Sxyther/HG_Badge_v1-0/BoM.xlsx

Part | Value | Device | Package | Description
C1 | 0.1uF | Capacitor | 0603-CAP | Capacitor | Any 0603 capacitor
C2 | 0.1uF | Capacitor | 0603-CAP | Capacitor | Any 0603 capacitor
C3 | 0.1uF | Capacitor | 0603-CAP | Capacitor | Any 0603 capacitor
C4 | 10uF | Capacitor | 1206-CAP | Capacitor Polarized | Any 1206 capacitor
C5 | 0.01uF | Capacitor | 0603-CAP | Capacitor | Any 1206 capacitor
C6 | 0.1uF | Capacitor | 0603-CAP | Capacitor | Any 0603 capacitor
C7 | 10uF | Capacitor | 0603-CAP | Capacitor | Any 0603 capacitor
C8 | 100pF | Capacitor | 0603-CAP | Capacitor | Any 0603 capacitor
FB1 | 300 ohm | FERRITE0805 | 0805-Ferrite | Ferrite Bead | https://www.digikey.com/product-detail/en/bourns-inc/MU2029-301Y/MU2029-301YTR-ND/1970484
FB2 | 300 ohm | FERRITE0805 | 0805-Ferrite | Ferrite Bead | https://www.digikey.com/product-detail/en/bourns-inc/MU2029-301Y/MU2029-301YTR-ND/1970484
LED1 | White | LED | 0603-LED | LEDs | https://www.digikey.com/product-detail/en/osram-opto-semiconductors-inc/LS-Q976-NR-1/475-2512-1-ND/1802639
LED2 | White | LED | 0603-LED | LEDs | https://www.digikey.com/product-detail/en/osram-opto-semiconductors-inc/LS-Q976-NR-1/475-2512-1-ND/1802640
LED3 | White | LED | 0603-LED | LEDs | https://www.digikey.com/product-detail/en/osram-opto-semiconductors-inc/LS-Q976-NR-1/475-2512-1-ND/1802641
LED4 | White | LED | 0603-LED | LEDs | https://www.digikey.com/product-detail/en/osram-opto-semiconductors-inc/LS-Q976-NR-1/475-2512-1-ND/1802642
LED5 | White | LED | 0603-LED | LEDs | https://www.digikey.com/product-detail/en/osram-opto-semiconductors-inc/LS-Q976-NR-1/475-2512-1-ND/1802643
LED6 | White | LED | 0603-LED | LEDs | https://www.digikey.com/product-detail/en/osram-opto-semiconductors-inc/LS-Q976-NR-1/475-2512-1-ND/1802644
LED7 | White | LED | 0603-LED | LEDs | https://www.digikey.com/product-detail/en/osram-opto-semiconductors-inc/LS-Q976-NR-1/475-2512-1-ND/1802645
Q1 | 8/16/20MHz | RESONATOR1:1 | RESONATOR-SMD-1:1 | Resonator | https://www.digikey.com/product-detail/en/murata-electronics-north-america/CSTCE16M0V53-R0/490-1198-1-ND/584635
R1 | 10K | RESISTOR0603-RES | 0603-RES | Resistor | Any 0603 resistor
R2 | 1K | RESISTOR0603-RES | 0603-RES | Resistor | Any 0603 resistor
R4 | 330 | RESISTOR0603-RES | 0603-RES | Resistor | Any 0603 resistor
R5 | 330 | RESISTOR0603-RES | 0603-RES | Resistor | Any 0603 resistor
R6 | 330 | RESISTOR0603-RES | 0603-RES | Resistor | Any 0603 resistor
R7 | 330 | RESISTOR0603-RES | 0603-RES | Resistor | Any 0603 resistor
R8 | 330 | RESISTOR0603-RES | 0603-RES | Resistor | Any 0603 resistor
R9 | 330 | RESISTOR0603-RES | 0603-RES | Resistor | Any 0603 resistor
R10 | 330 | RESISTOR0603-RES | 0603-RES | Resistor | Any 0603 resistor
R11 | 1K | RESISTOR0603-RES | 0603-RES | Resistor | Any 0603 resistor
R12 | 1K | RESISTOR0603-RES | 0603-RES | Resistor | Any 0603 resistor
R13 | 1M | RESISTOR0603-RES | 0603-RES | Resistor | Any 0603 resistor
R14 | 1M | RESISTOR0603-RES | 0603-RES | Resistor | Any 0603 resistor
R15 | 1k | RESISTOR0603-RES | 0603-RES | Resistor | Any 0603 resistor
R16 | 22k | RESISTOR0603-RES | 0603-RES | Resistor | Any 0603 resistor
U1 | ATMEGA328 | ATMEGA168 | TQFP32-08 |  | https://www.digikey.com/product-detail/en/microchip-technology/ATMEGA328-AUR/ATMEGA328-AURCT-ND/3440951
U2 | MAX4466EXK+T | MAX4466"" | SC70-5 | MAX4466 - Microphone Pre-Amp | https://www.digikey.com/product-detail/en/maxim-integrated/MAX4466EXK-T/MAX4466EXK-TR-ND/1781624
