Sxyther/HG_Badge_v1-0/HG_Badge_v1-0.pdf

# AGND 5 AREF 20

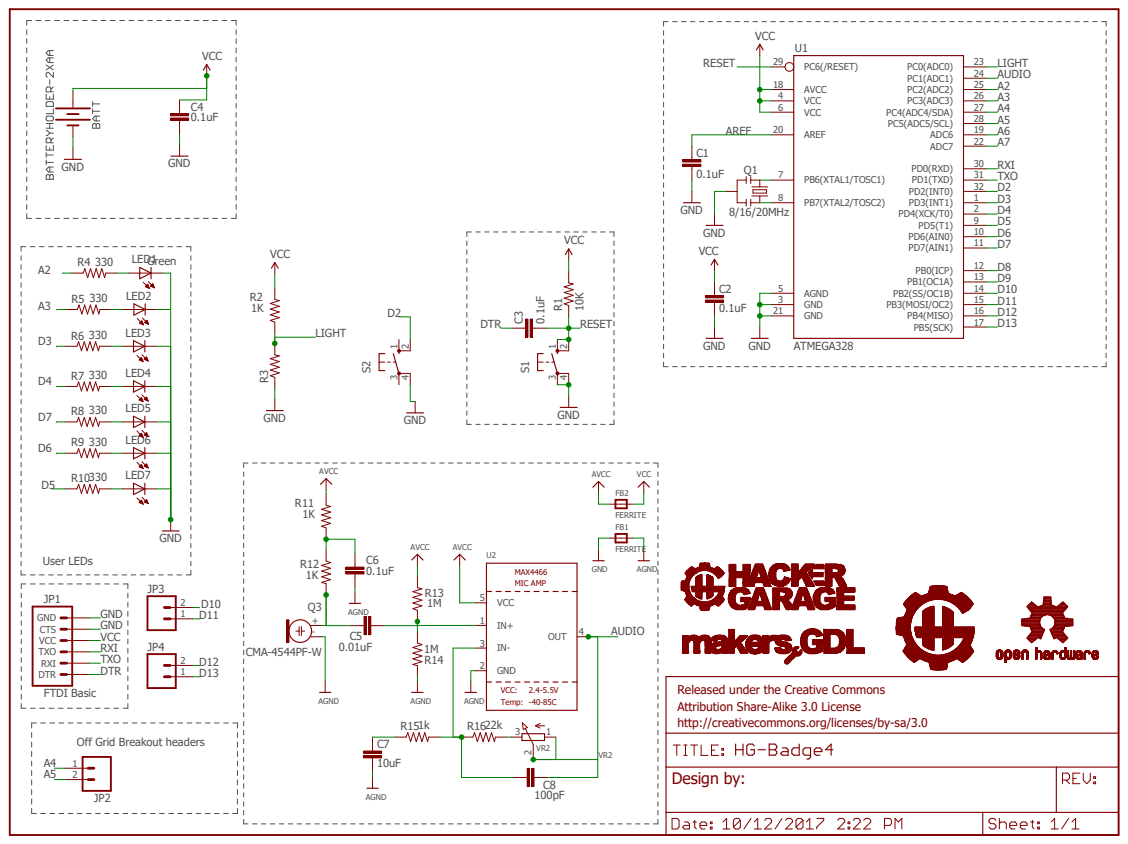
[picture p1: page 1]

Released under the Creative Commons
Attribution Share-Alike 3.0 License
http://creativecommons.org/licenses/by-sa/3.0
