Sxyther/HG_Badge_v1-0/HG-Badge6.brd

## EAGLE design HG-Badge6.brd (2018-12-18)

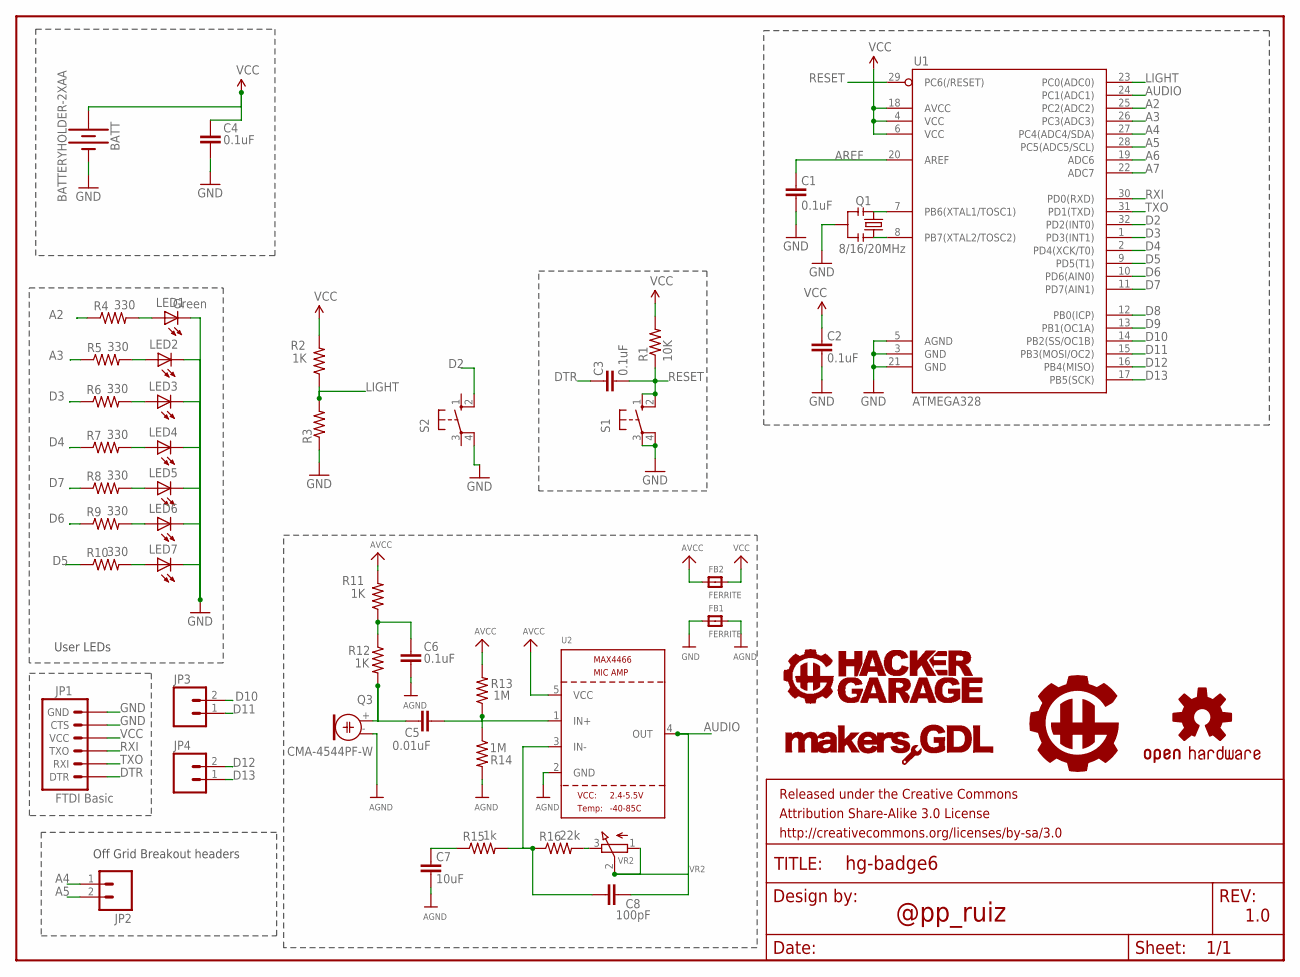
[picture p2: schematic HG-Badge6.sch]

Parts:
BATT: BATTERYHOLDER-2XAA; BATT-HOLDER-2XAAA
C1, C2, C3, C4, C6: 0.1uF; 0603-CAP
C5: 0.01uF; 0603-CAP
C7: 10uF; 0603-CAP
C8: 100pF; 0603-CAP
FB1, FB2: FERRITE; 0805
FRAME1: FRAME-LETTER; CREATIVE_COMMONS
JP1: FTDI Basic; 1X06
JP2, JP3, JP4: M02PTH; 1X02
LED1, LED2, LED3, LED4, LED5, LED6, LED7: Green; 0603-LED-ALT1
Q1: 8/16/20MHz; RESONATOR-SMD-1:1
Q3: CMA-4544PF-W; ELECTRET_9.7
R1: 10K; 0603-RES
R2, R11, R12: 1K; 0603-RES
R3: R-US_0204/2V; 0204V
R4, R5, R6, R7, R8, R9, R10: 330; 0603-RES
R13, R14: 1M; 0603-RES
R15: 1k; 0603-RES
R16: 22k; 0603-RES
S1, S2: 10-XX; B3F-10XX
U1: ATMEGA328; TQFP32-08
U2: MAX4466EXK+T; SC70-5
U$1: HG-BADGE-FULL; HG-BADGE
U$3: OSHW-LOGOS; OSHW-LOGO-S
U$4: MAKERSGDLLOGO-SMALL; MAKERSGGL-SMALL
U$5: HACKERGARAGEFULL; HACKERGARAGEFULL-SMALL
VR2: VR2; TRIMPOT_BOURNS_TC33X-2

Connections:
A2: R4.1, U1.25 (PC2(ADC2))
A3: R5.1, U1.26 (PC3(ADC3))
A4: JP2.1, U1.27 (PC4(ADC4/SDA))
A5: JP2.2, U1.28 (PC5(ADC5/SCL))
A6: U1.19 (ADC6)
A7: U1.22 (ADC7)
AGND: C6.1, C7.1, FB1.2, Q3.- (1), R14.2, U2.2 (GND)
AREF: C1.2, U1.20 (AREF)
AUDIO: C8.1, U1.24 (PC1(ADC1)), U2.4 (OUT), VR2.1 (A), VR2.2 (S)
AVCC: FB2.1, R11.2, R13.2, U2.5 (VCC)
D2: S2.2 (S1), U1.32 (PD2(INT0))
D3: R6.1, U1.1 (PD3(INT1))
D4: R7.1, U1.2 (PD4(XCK/T0))
D5: R10.1, U1.9 (PD5(T1))
D6: R9.1, U1.10 (PD6(AIN0))
D7: R8.1, U1.11 (PD7(AIN1))
D8: U1.12 (PB0(ICP))
D9: U1.13 (PB1(OC1A))
D10: JP3.2, U1.14 (PB2(SS/OC1B))
D11: JP3.1, U1.15 (PB3(MOSI/OC2))
D12: JP4.2, U1.16 (PB4(MISO))
D13: JP4.1, U1.17 (PB5(SCK))
DTR: C3.2, JP1.1 (DTR)
GND: BATT.P$1 (-), C1.1, C2.1, C4.1, FB1.1, JP1.5 (CTS), JP1.6 (GND), LED1.C, LED2.C, LED3.C, LED4.C, LED5.C, LED6.C, LED7.C, Q1.2, R3.1, S1.3, S1.4 (P1), S2.4 (P1), U1.3 (GND), U1.5 (AGND), U1.21 (GND)
LIGHT: R2.1, R3.2, U1.23 (PC0(ADC0))
unnamed: Q1.3, U1.8 (PB7(XTAL2/TOSC2))
unnamed: Q1.1, U1.7 (PB6(XTAL1/TOSC1))
unnamed: LED4.A, R7.2
unnamed: LED5.A, R8.2
unnamed: LED6.A, R9.2
unnamed: LED7.A, R10.2
unnamed: LED3.A, R6.2
unnamed: LED2.A, R5.2
unnamed: LED1.A, R4.2
unnamed: C8.2, R15.2, R16.1, U2.3 (IN-)
unnamed: C5.2, Q3.+ (2), R12.2
unnamed: C6.2, R11.1, R12.1
unnamed: C5.1, R13.1, R14.1, U2.1 (IN+)
unnamed: R16.2, VR2.3 (E)
unnamed: C7.2, R15.1
RESET: C3.1, R1.1, S1.1 (S), S1.2 (S1), U1.29 (PC6(/RESET))
RXI: JP1.3 (TXO), U1.30 (PD0(RXD))
TXO: JP1.2 (RXI), U1.31 (PD1(TXD))
VCC: BATT.P$2 (+), C2.2, C4.2, FB2.2, JP1.4 (VCC), R1.2, R2.2, U1.4 (VCC), U1.6 (VCC), U1.18 (AVCC)

Notes on the sheet:
Off Grid Breakout headers
User LEDs
1.0
@pp_ruiz

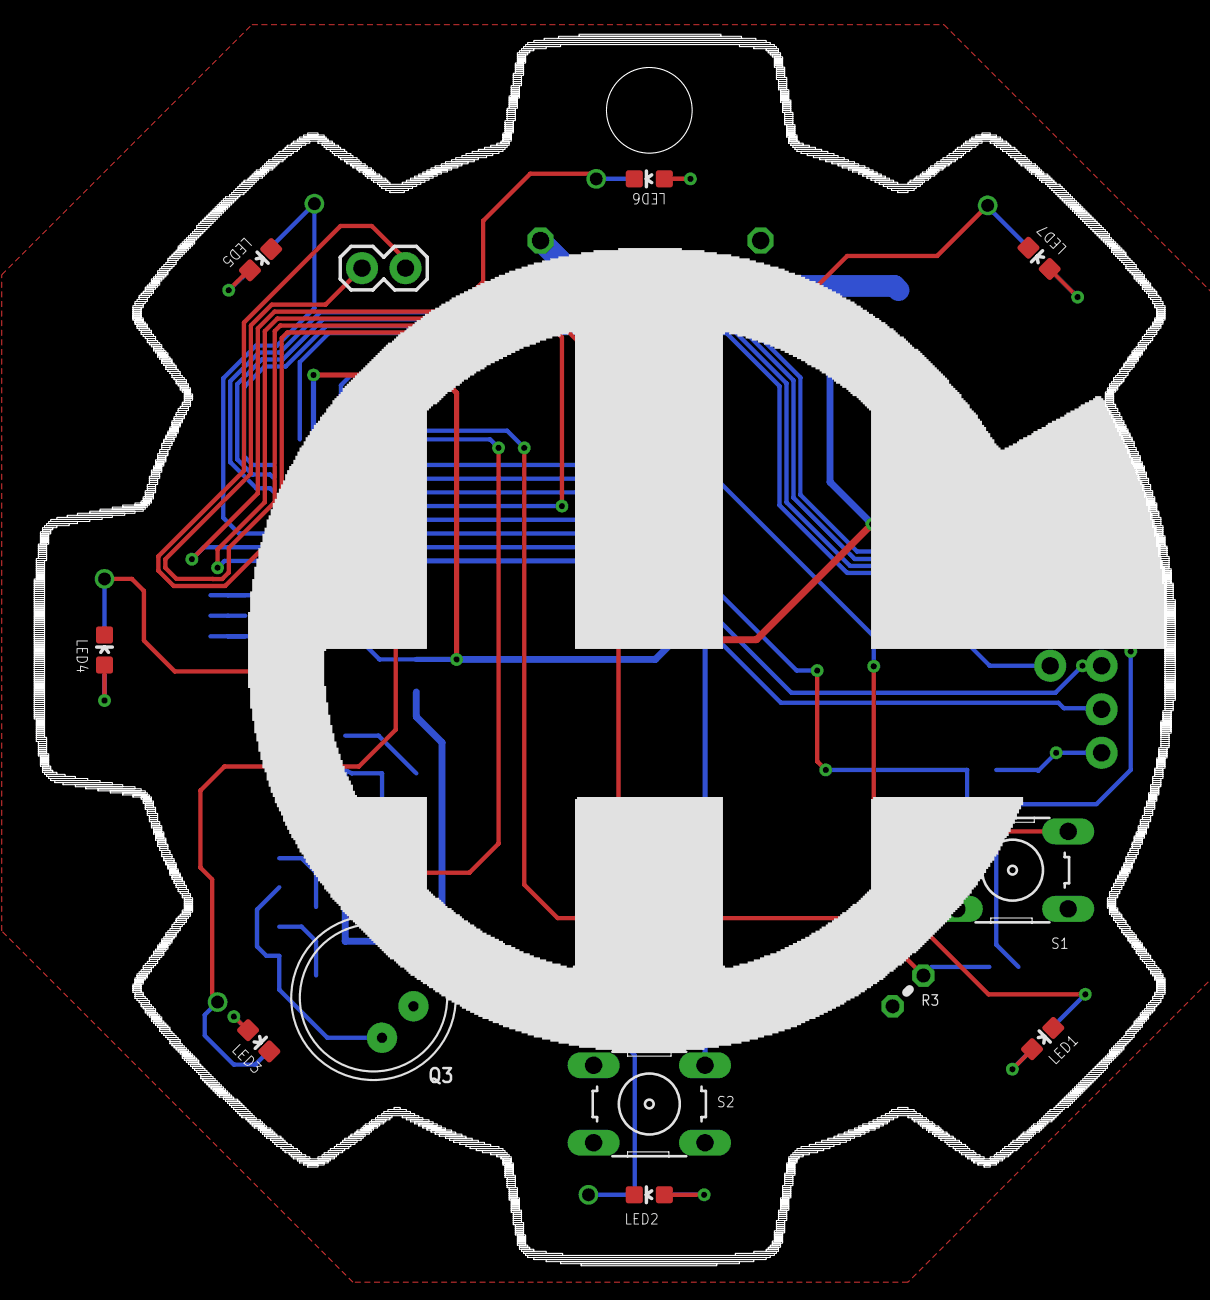
[picture p3: board HG-Badge6.brd from above]

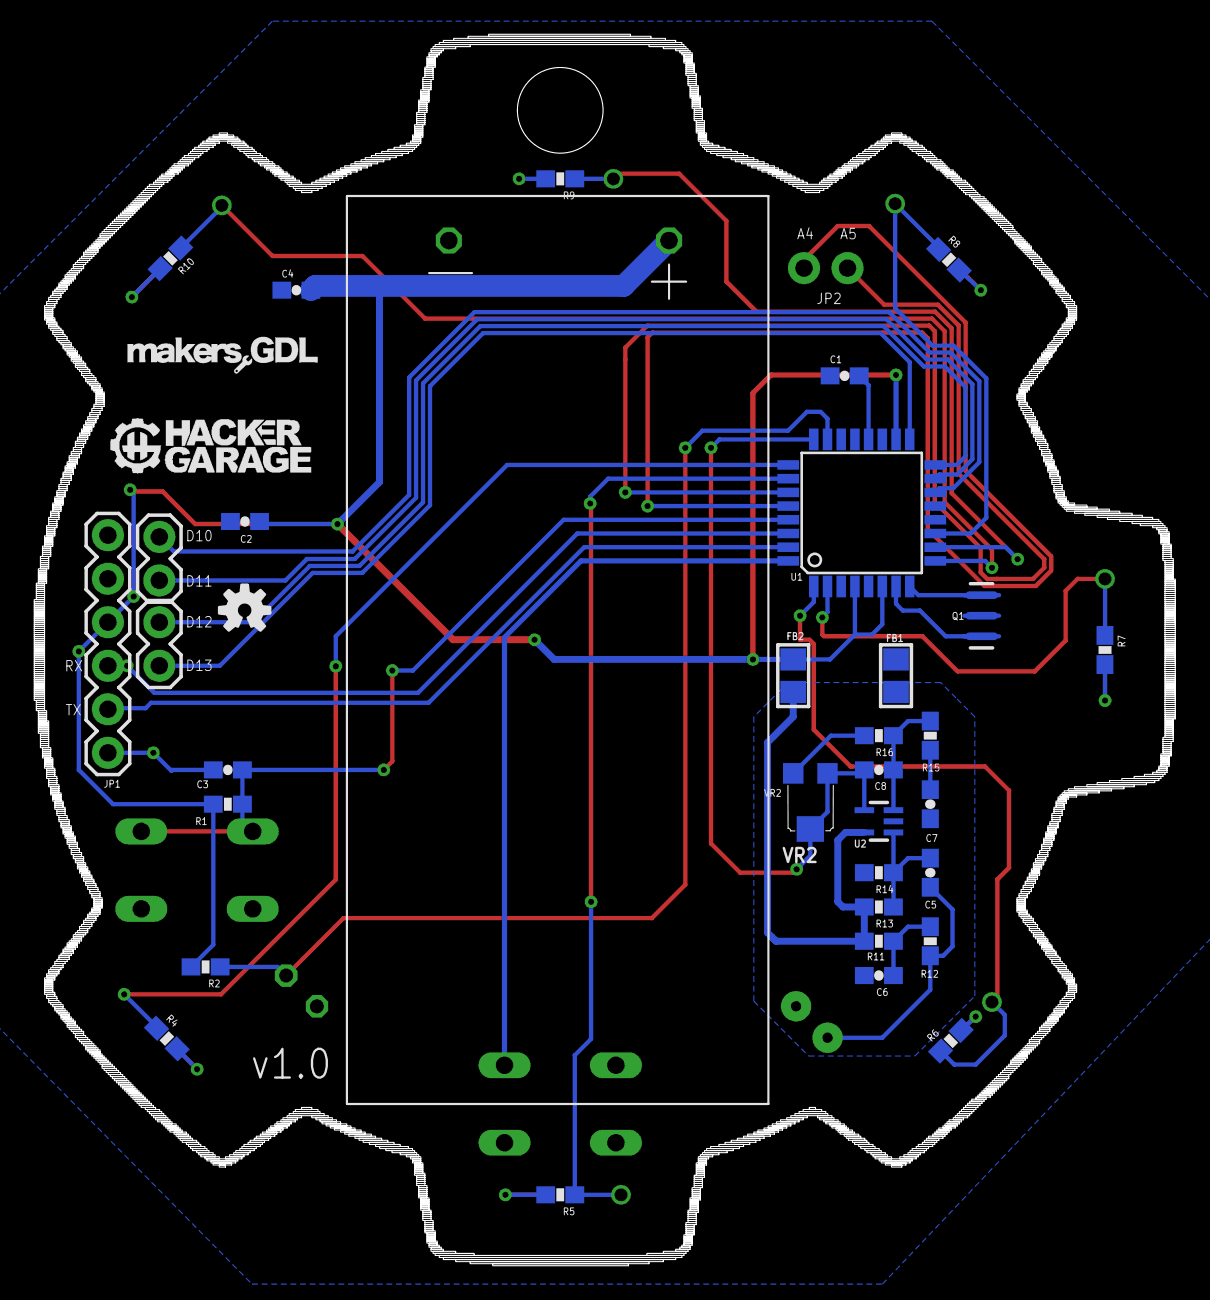
[picture p4: board HG-Badge6.brd from below]

Board: 2 copper layers, 66.6 x 71.9 mm, 50 parts (36 on the bottom side), 40 nets.
